tiroin/railway_barrier_circuit/12v-relay-1.snapshot.1/Ekran Alıntısı.PNG

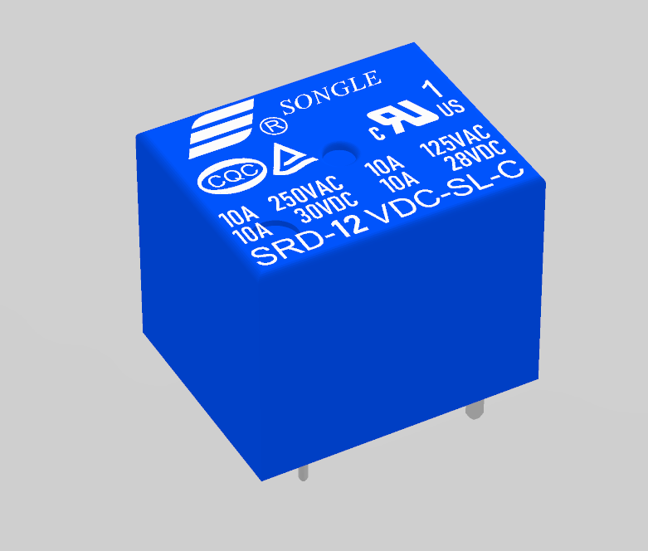
12v-relay-1.snapshot.1/Ekran Alıntısı.PNG
