tiroin/railway_barrier_circuit/(list of files, drawings)

Other design files:
bai1.PrjPcb
bai2.PrjPcb
khoinguonbai2.pdsprj
led7doan.pdsprj
Machtong.pdsprj
PCBDK.PcbDoc
PCBDK.PrjPcb
SOURCE.PcbDoc
SOURCE.PrjPcb
